StonesGate604/Tabletop-OS/pc-runtime/models/README.md

# MediaPipe 手部模型

模型二进制不提交到仓库。执行：

```powershell
python pc-runtime/tools/download_hand_model.py
```

固定资源：`hand_landmarker/float16/1`，7819105 字节。
SHA256：`fbc2a30080c3c557093b5ddfc334698132eb341044ccee322ccf8bcf3607cde1`。
下载脚本会验证哈希；程序不会在启动时自动联网下载。

来源与模型说明：[MediaPipe 官方 Hand Landmarker](https://developers.google.com/edge/mediapipe/solutions/vision/hand_landmarker)。
