StonesGate604/Tabletop-OS/docs/Tabletop_OS_Project_Context.md

# Tabletop OS 项目上下文与当前架构基线

> **2026-10-26 状态更新：** PC Runtime、双捏合与舵机升降序列、仿真、离线视觉和 PC→Pi TOSF 最终帧通道现已实现并通过软件测试。本机升降端点已实测为 81° 最高吸附、118° 最低释放，测试链路使用 45 mm/s；行程复测为 X=298 mm（`344−46`）、Y=466 mm（`514−48`），旧机械相机标定已失效。稳定时间、安全间距和真实硬件闭环仍待验。当前实现以 [技术说明书](TABLETOP_OS_TECHNICAL_GUIDE_ZH.md) 和 [实机联调记录](HARDWARE_COMMISSIONING_ZH.md) 为准；下文的 2026-10-12 状态与后续建议保留为历史背景，不应当作最新功能清单。

> 用途：给当前及后续 Codex 任务提供统一上下文。开始新任务时，先让 Codex 阅读本文件和相关模块的 README，再决定是否修改代码。
>
> 更新原则：本文件区分“当前事实”“近期目标”和“未来设计”。讨论过的能力不等于已经实现。
>
> **架构更新（2026-10-12）：** 本文中由 Pi 直接绘制光标和拖影的描述，记录的是已经实现并保留的 v0.1 诊断基线。正式产品边界已经调整为“PC 合成最终画面，Pi 只接收像素并输出 HUB75”。当前边界以仓库根目录 `README.md` 和 `protocol/README.md` 为准。

## 1. 项目一句话

Tabletop OS 是一个结合摄像机感知、HUB75 灯光反馈、CoreXY 电磁驱动和游戏逻辑的实体数字桌游系统。最终目标是让玩家、确定性的游戏规则和 LLM 都能提出高层意图，并由桌面通过光与棋子运动作出可见、可验证的物理回应。

LLM 永远不直接控制电机。任何由 LLM 或游戏逻辑提出的动作，都必须先经过规则与安全层验证，再转成有限、明确的运动命令。

## 2. 当前仓库事实（2026-10-12）

仓库中已经存在：

- `experiments/arduino/CoreXY_Controller/`：Arduino UNO R3 + CNC Shield V3 + A4988 的 CoreXY 调试固件与说明。
- `experiments/arduino/Limit_Servo_Test/`：两个限位开关与舵机的独立测试程序。
- `experiments/arduino/Integrated_Hardware_Test/`：两个步进电机、两个限位开关和舵机的联合测试程序；实物测试已通过。
- `firmware/arduino/TabletopOS_Lower_Controller/`：正式下位机固件及协议说明。重新测得 X=298 mm（`344−46`）、Y=466 mm（`514−48`），减数为 moving carriage 尺寸；两个限位均位于最小端起点。当前正式固件使用 `X_AXIS_SIGN=1`、`Y_AXIS_SIGN=1`，两个回零方向均为 `-1`，使 X/Y 分别向左、向下寻找起点限位。两个 A4988 驱动插槽下的三个细分跳帽均已安装，固件按 1/16 细分、GT2 皮带和 16 齿同步轮配置为 `100 steps/mm`。
- `experiments/raspberry-pi/gpio_high_test.py`：已有 GPIO/HUB75 方向的测试代码。
- `docs/Tabletop_OS_Development_Roadmap.md` 与 `docs/Tabletop_OS_中文路径规划图.md`：较长期的产品与研究路线。

旧版 `CoreXY_Controller` 调试固件的真实能力：

- 支持 `ENABLE`、`ZERO`、`MOVE x y speed`、`JOG dx dy speed`、`POS`、`DISABLE` 和即时停止字符 `!`。
- `MOVE` 是阻塞式、一次完成一个目标的任务语义；运动中除 `!` 外的输入会被丢弃。
- 位置来自步进脉冲计数，是开环机构位置估计，不是棋子位置真值。
- `ZERO` 是手动设零，不是自动回零。
- 尚未实现连续更新目标的 `SET_TARGET`、命令编号、周期遥测、WebSocket 桥接或完整 HUB75 联动。
- 该旧版仍可用于手动点动排障，但不再作为正式通信固件。

当前 `TabletopOS_Lower_Controller` 正式固件的真实能力：

- 非阻塞执行自动 `HOME`、带编号的 `MOVE_TO` 和最新值语义的 `SET_TARGET`；运动过程中仍持续解析串口。
- 返回 `ACK`、`STARTED`、`COMPLETED`、`ERROR` 和可选周期 `STATE` 快照，并拒绝旧任务编号或倒序目标序号；周期遥测上电默认关闭，可用 `TELEMETRY ON/OFF` 控制。
- 具有受控 `STOP`、即时 `!`、软限位、意外硬限位故障、跟随目标超时、舵机超时和错误恢复状态。
- 已使用本机 Arduino AVR 工具链为 Arduino Uno 编译通过。当前代码参数为：任务移动软件上限 50 mm/s、连续跟随 20 mm/s、加速度 60 mm/s²、最大 8000 步进事件/秒、回零速度 8/2 mm/s。50 mm/s 尚未完成实物验证；自动回零、全行程软限位、分级速度和连续跟随仍需按当前 1/16 细分配置重新测试。

## 3. 现在真正要完成的目标

不要直接实现完整 Tabletop OS。当前集成目标是建立一条最小、可观察的“手势选取并移动单个磁性棋子”闭环：

```text
摄像机跟踪手在桌面上的位置
   ↓ PC 在最终画布中绘制实时圆环光标
PC 发送完整像素帧，Pi 输出到 HUB75
   ↓ 光标只是视觉反馈，不驱动机构
手位于棋子上方并做抓取手势
   ↓ 选中当前棋子
手移动到目标位置
   ↓ 圆环继续跟随并更新目标预览，不驱动机构
释放或明确的确认手势
   ↓ 生成一次 MOVE_TO 任务
PC → Raspberry Pi → Arduino / CoreXY
   ↓
机构移动磁性棋子
   ↓ Arduino STATE 位置估计
Raspberry Pi 回传实际坐标 → PC 生成蓝色轨迹 → Pi 显示最终帧
   ↓
轨迹在保留一段时间后逐渐熄灭
```

推荐按下面顺序推进：

1. 按当前 1/16 细分配置，让 Arduino 单独可靠完成回零和小范围 `MOVE_TO`。
2. Pi 通过串口发送单次目标，并正确处理 `ACK`、`STARTED`、`COMPLETED`、`ERROR` 和 `STATE`。
3. 先用已经实现的 Pi 本地蓝色轨迹验证 Arduino 遥测、坐标方向和 HUB75 映射；这一步属于 v0.1 诊断模式。
4. 实现 PC 最终画面合成与 Pi 像素帧接收，用鼠标模拟手部位置；PC 绘制圆环、目标预览和基于实际机构坐标的蓝色轨迹，Pi 只显示最终帧。
5. 用摄像机手部识别替换鼠标：手部位置持续更新 PC 画布，抓取手势只锁定棋子，手移动同时更新光标和目标预览，释放或确认手势才提交一次 `MOVE_TO`。
6. 完成单磁性棋子的完整演示后，再加入 AprilTag 棋子身份、网格坐标、游戏规则、专用游戏编写工具和 LLM。

当前最有价值的阶段性演示是：

> 用户的手进入有效桌面区域后，PC 在最终画布中生成实时圆环光标并发送给 Pi 显示。用户在棋子上方做抓取手势将其选中，把手移到另一处并做释放或确认手势；系统随后移动该磁性棋子。PC 根据 Pi 回传的机构实际坐标生成不含红色的蓝色轨迹拖影，Pi 显示最终画面，轨迹在设定时间后消失。

第一版只处理一个已知磁性棋子，不要求先完成多棋子身份识别。选中与目标手势在提交前都属于 PC 端交互状态，不应直接流式控制电机。

## 4. 三层职责

### PC：Tabletop OS 专用编写程序、感知与高层决策

第一版负责：

- 运行专门为 Tabletop OS 设计的游戏编写与运行程序，不以兼容 Unity、Godot、p5.js 等通用游戏引擎为目标；
- 读取鼠标或摄像机输入；
- 识别手的位置以及抓取、移动、释放/确认手势；
- 维护 `IDLE → SELECTED → AIMING → COMMITTED → MOVING` 的本次交互状态；
- 将相机坐标转换为统一的桌面物理坐标；
- 在手部跟踪有效时，在 PC 画布中生成实时圆环、目标预览和相关动画；
- 根据 Pi 回传的 Arduino 实际坐标生成运动轨迹；
- 合成最终 64×96 画面并通过画面通道发送给 Pi；
- 只在动作提交后向 Pi 发送一次经过边界检查的移动任务；
- 可选地显示调试信息。

以后才负责：

- AprilTag 棋子识别；
- 棋盘格映射；
- 游戏规则、逻辑状态和玩家动作判断；
- LLM 意图解析及规则验证；
- 棋子状态估计与系统运动验证。

### Raspberry Pi：协调、桥接与灯光

正式运行负责：

- 接收 PC 已确认的单次移动目标；
- 接收 PC 合成的最终像素帧，丢弃不完整或过期帧，并在 VSync 时输出到 HUB75；
- 只处理面板排列、方向、亮度、超时清屏和故障红色通道屏蔽，不理解光标、棋子或游戏特效；
- 为目标分配或校验命令编号，并把一次 `MOVE_TO` 任务发给 Arduino；
- 接收 Arduino 的状态或位置回报；
- 把 Arduino 的状态与实际位置回传给 PC，作为 PC 生成真实运动轨迹的输入；
- 维护 PC 连接和串口连接的健康状态；
- 在连接断开、命令失败或状态异常时停止新任务并回报错误。

Pi 是当前系统协调器，但不应替 Arduino 生成精确步进脉冲，也不应让 Arduino 保存一长串游戏动作队列。

已经实现的 Pi Bridge v0.1 仍会接收手部位置并在本地绘制圆环，同时根据 Arduino `STATE` 绘制蓝色拖影。这一功能保留为坐标、面板与机构链路的诊断基线。正式运行时这些图层全部在 PC 合成，Pi 只接收最终像素。

### Arduino：低层运动与硬件安全

负责：

- CoreXY 步进时序、方向、速度与加减速；
- 位置计数和软行程检查；
- 限位、回零、停止和故障状态；
- 执行当前运动任务，或在连续模式下追踪最新目标；
- 回报自身的机构位置、当前目标、模式与错误。

Arduino 知道的是执行器/磁铁的位置估计，不应声称自己直接知道棋子实际在哪里。

## 5. 两种运动语义

正式协议必须区分任务式运动和连续目标更新。它们不冲突，服务于不同场景。

### 5.1 `MOVE_TO`：任务语义

示意：

```text
MOVE_TO 142 300.0 400.0 20.0
```

含义：执行编号为 `142` 的完整运动任务，到达后报告完成。适用于：

- 把棋子从一个格子移动到另一个格子；
- 回合制游戏动作；
- 校准或明确的点到点操作。

Pi 一次只下发一个任务，等待该任务完成或失败，再决定下一步。Arduino 不维护长游戏任务队列。

当前“抓取选中—移动手—释放确认”的演示使用 `MOVE_TO`。手在空中移动时只改变 PC 端的目标预览；只有释放或明确确认后才创建一个新的 `command_id` 并提交任务。

### 5.2 `SET_TARGET`：最新值语义

示意：

```text
SET_TARGET 501 300.0 400.0
SET_TARGET 502 315.0 407.0
SET_TARGET 503 330.0 420.0
```

含义：进入连续跟随模式，并用序号更大的新目标覆盖旧目标。适用于：

- 手部追踪；
- 鼠标、摇杆或远程操控；
- 调试与遥操作。

`SET_TARGET` 不用于当前的棋子放置手势演示，否则机构会在用户尚未确认目标时持续追随手部位置。该命令保留给以后明确选择的连续遥操作模式。

这三条不是三个等待完成的任务。Arduino 始终追踪最新有效目标；如果 `502` 之后才收到 `501`，应忽略 `501`。

### 5.3 当前实现与目标协议的关系

旧版 `CoreXY_Controller` 的 `MOVE x y speed` 是 `MOVE_TO` 的早期原型，没有 `command_id`，并且运动期间阻塞；它不再作为正式通信固件。当前 `TabletopOS_Lower_Controller` 已实现非阻塞、带编号的 `MOVE_TO` 和最新值语义的 `SET_TARGET`。

## 6. 最小通信协议建议

当前 PC 与 Pi 使用 TCP 7420 的 NDJSON 控制通道和 UDP 7421 的 v0.1 诊断光标通道；下一版将在此基础上增加或替换为最终像素帧通道。Pi 与 Arduino 使用 115200 波特单行文本串口协议。

### 6.1 Pi → Arduino

近期需要的命令：

```text
ENABLE
HOME
MOVE_TO <command_id> <x_mm> <y_mm> <speed_mm_s>
SET_TARGET <target_seq> <x_mm> <y_mm>
STOP
STATUS
DISABLE
```

说明：

- `HOME` 已在当前正式固件中实现，包含快寻、退回和慢速二次触发；旧版实验固件中的手动 `ZERO` 不能代替回零。
- `STOP` 表示软件受控停止；真实硬件急停仍应能切断危险输出。
- 电磁铁控制以后再加入 `MAGNET_ON` / `MAGNET_OFF`，并必须带超时与热安全策略。

### 6.2 Arduino → Pi

建议的事件：

```text
ACK <command_id>
STARTED <command_id>
COMPLETED <command_id>
ERROR <code> <related_id>
```

建议的周期状态快照：

```text
STATE <telemetry_seq> <mode> <active_id> <actual_x_mm> <actual_y_mm> <target_x_mm> <target_y_mm>
```

V0 不必一次实现全部字段。最低限度可以先有：

```text
POS <telemetry_seq> <x_mm> <y_mm>
```

### 6.3 PC ↔ Pi

PC 与 Pi 在调试阶段可以使用同样的概念，但消息可以是 JSON，方便扩展。例如：

```json
{
  "type": "pointer_state",
  "seq": 2401,
  "visible": true,
  "x_mm": 126.0,
  "y_mm": 284.0,
  "gesture": "open",
  "confidence": 0.94,
  "captured_at_ms": 1750000000000
}
```

`pointer_state` 使用“最新值覆盖”语义，不需要 ACK，只能更新 HUB75 光标。Pi 丢弃倒序帧，并在约 200 ms 没有收到新位置时隐藏或快速淡出光标，避免将旧位置冻结在桌面上。该消息不能被转发为 Arduino 命令。

只有释放或明确确认手势才产生可靠的移动任务，例如：

```json
{
  "type": "move_to",
  "command_id": 503,
  "x_mm": 330.0,
  "y_mm": 420.0,
  "speed_mm_s": 20.0,
  "sent_at_ms": 1750000000000
}
```

Pi 回给 PC 的状态示例：

```json
{
  "type": "motion_state",
  "seq": 3812,
  "mode": "TRACKING",
  "active_id": 503,
  "actual_x_mm": 324.0,
  "actual_y_mm": 410.0,
  "target_x_mm": 330.0,
  "target_y_mm": 420.0,
  "telemetry_age_ms": 6
}
```

这些是目标格式，不代表仓库已经实现。

## 7. 同步原则

PC、Pi 和 Arduino 不需要共享同一个循环，也不需要逐帧锁步。

可能的独立速率是：

- Arduino 控制循环：数百 Hz 或由定时器/步进规划器决定；
- Arduino 遥测：约 20–100 Hz，按串口负载实测；
- PC 渲染：约 60 Hz；
- CV：约 30 Hz；
- PC → Pi 光标位置：跟随 CV，约 30 Hz，只保留最新值；
- 当前演示的 `MOVE_TO`：只在释放/确认时提交一次；以后启用的连续 `SET_TARGET` 才使用限频和最新值语义。

同步依靠以下机制：

- 离散任务使用 `command_id`，明确 ACK、开始、完成或失败属于哪个任务；
- 连续目标使用单调递增的 `target_seq`，旧目标不覆盖新目标；
- 遥测使用 `telemetry_seq`，接收方忽略倒序或重复包；
- 周期发送完整状态快照，使漏掉单个事件后仍能恢复；
- PC/Pi 保存接收时间并计算 `telemetry_age_ms`；
- 连接超时或目标太旧时进入安全停止，而不是无限追踪最后一个旧目标。

数据所有权必须清楚：

- PC 拥有高层意图、逻辑游戏状态和视觉观察；
- Pi 拥有连接状态、最近目标、最新手部光标镜像和 Arduino 状态镜像；
- Arduino 拥有实时执行器状态和硬件故障状态。

## 8. Arduino 目标状态机

目标状态可以保持很小：

```text
UNREFERENCED
    └── HOME / ZERO 成功 → IDLE

IDLE
    ├── MOVE_TO → TASK_MOVE
    ├── SET_TARGET → TRACKING
    └── DISABLE → UNREFERENCED

TASK_MOVE
    ├── 到达 → COMPLETED → IDLE
    ├── STOP → IDLE 或 UNREFERENCED（取决于是否可能失步）
    └── 限位/故障 → ERROR

TRACKING
    ├── 新 SET_TARGET → 留在 TRACKING，覆盖目标
    ├── STOP / 超时 → IDLE
    └── 限位/故障 → ERROR

ERROR
    └── 明确复位并重新建立坐标参考 → IDLE
```

是否在受控停止后保留坐标参考，要依据实际步进与机械行为决定。现有 `!` 会释放电机并使原点失效，这是当前安全假设，不应在没有实测依据时放宽。

## 9. “两个声音”：机构估计与视觉观察

加入 AprilTag 后，同一个棋子的移动会同时产生两类信息：

- Arduino：磁铁/执行器根据脉冲计数估计到哪里；
- Camera + CV：棋子的 AprilTag 被实际观察在哪里。

这不是重复数据，也不应强行合并为一个变量：

```text
commanded_position   系统要求去哪里
actuator_position    机构估计磁铁在哪里
vision_observation   摄像机看到棋子在哪里
estimated_position   系统综合判断棋子在哪里
logical_position     游戏规则已经确认的棋盘位置
```

运动过程中，机构估计适合提供低延迟轨迹；视觉适合检查棋子是否跟上磁铁。运动结束后，棋子的最终物理位置应由视觉确认，而不是仅凭电机“已经到达”。

未来系统移动棋子时，要设置类似以下上下文：

```text
motion_owner = SYSTEM
active_command_id = 142
```

此时 CV 仍更新观察值，但不能把系统造成的位移再解释成一次玩家动作。Arduino 报告完成后，还需等待视觉确认目标棋子稳定在期望位置，才能提交游戏状态。

玩家手动移动棋子时，如果没有活动的系统运动，CV 才能在位置稳定一段时间后产生候选 `PLAYER_MOVE`。

以上属于 AprilTag 阶段的设计约束，当前手部跟随演示不需要实现 `WorldModel`、`StateEstimator` 或 `motion_owner` 类。

## 10. 坐标约定

模块之间统一传递桌面物理坐标，单位使用毫米：

```text
camera pixels
    ↓ 标定/透视变换
board coordinates (x_mm, y_mm)
    ↓ CoreXY 运动学
motor A/B steps
```

约定必须在实现前写清：

- 原点在桌面的哪个角或哪个机械参考点；
- X、Y 正方向；
- 可运动边界；
- 摄像机画面是否镜像或旋转；
- HUB75 像素方向；
- 毫米到 LED 像素、毫米到步数的变换。

PC 不发送电机 A/B 步数，Pi 不猜相机像素。所有跨设备目标先转换为板面毫米坐标。

## 11. HUB75 行为

正式画布由 PC 合成。推荐的图层顺序是：棋盘/游戏底图 → 基于 Arduino 实际位置的运动轨迹 → 选中与目标提示 → 实时跟手圆环。PC 将这些图层压平为最终 64×96 像素帧后发送给 Pi。

Pi 的显示循环必须独立于网络和串口消息到达，只负责保存最新完整帧并在 VSync 时切换：

```text
latest_complete_frame
last_frame_received_at
display_health
```

Pi 还负责面板物理映射、亮度、颜色输出限制和帧超时清屏。因为当前面板的红色通道存在局部故障，硬件输出层暂时继续强制 `R=0`。灯板刷新不能反过来阻塞运动通信。

Pi Bridge v0.1 中的 `latest_hand_cursor`、`trail_history` 和本地图层合成只作为诊断模式保留，用于在 PC Runtime 完成前验证硬件链路；它们不属于最终游戏渲染接口。

## 12. 安全底线

- 首次测试只做低速、小距离、空载或解除危险连杆的动作。
- 软限位依赖坐标参考与不失步，不能替代硬件限位和物理急停。
- 电机、电磁铁和舵机的电源、限流、共地与散热必须依据具体器件确认。
- 电磁铁必须有默认关闭、最长通电时间与异常断连关闭策略。
- 网络断开、串口断开、目标数据过期、限位触发和解析错误都必须导向定义明确的安全状态。
- 任何 LLM 输出只能成为待验证的高层建议，不能直接进入串口或 GPIO。

## 13. 分阶段验收标准

### M0：CoreXY 单机验证（当前最近目标）

- 上电后发送 `CONFIG`，确认实物跳帽与 `MICROSTEPS=16`、`STEPS_PER_MM=100` 一致；
- `HOME` 的 X/Y 寻限位方向、退回和二次慢速触发均符合预期；
- 使用正式固件的 `MOVE_TO` 低速完成中心附近的小范围正方形；
- `!`、`STOP`、软边界和硬限位故障行为经过实物验证；
- 记录实测距离误差、可靠速度、加速度和可能发生失步的边界。

### M1：Pi → Arduino 单任务链路

- Pi 能发送一个点到点目标；
- Arduino 明确返回接受、完成或错误；
- 不重复执行旧命令；
- 断连和停止行为可预测。

### M2：Arduino → Pi → HUB75 诊断轨迹

- Pi 持续获得机构位置；
- HUB75 独立刷新，不因串口间歇而冻结；
- 显示位置方向与实体运动方向一致。
- 轨迹只使用蓝色通道，所有轨迹像素保持 `R=0`；
- 每个轨迹点带时间戳，并在可配置寿命内逐渐变暗直至清除；
- 轨迹来源是 Arduino 回报的位置估计，而不是 PC 预期路径。
- 这一里程碑验证的是 v0.1 诊断渲染，不固定最终职责边界。

### M3：鼠标模拟选取与放置

- 鼠标进入有效桌面区域后，HUB75 始终在对应位置显示圆环光标；
- 圆环、目标预览和轨迹由 PC 合成到最终帧，Pi 不解析这些视觉语义；
- 第一次点击模拟在棋子上方抓取并选中；
- 鼠标移动持续更新 HUB75 光标和目标预览，不驱动机构；
- 第二次点击或确认操作生成一个带编号的 `MOVE_TO`；
- PC 能看到任务的接受、开始、完成或错误状态；
- 任务执行时，HUB75 显示随实际机构位置生成的蓝色拖影。

### M4：手势选取与移动完整闭环

- 用摄像机手部坐标和抓取/释放手势替换鼠标，不改变 Pi/Arduino 边界；
- 跟踪有效时，HUB75 圆环始终位于手下方；抓取只改变圆环样式和交互状态；
- 只有手位于当前磁性棋子上方并满足抓取判定时才能进入 `SELECTED`；
- 手移动期间持续更新圆环光标和经过标定的目标预览，但不驱动机构；
- 释放或确认手势提交一次 `MOVE_TO`，随后进入 `MOVING` 并暂时拒绝新的手势任务；
- 手丢失、手势取消、目标越界或连接异常不会触发运动；
- 同屏或日志显示 selection、target、actual、命令编号、延迟与状态；
- 完成后蓝色轨迹按设定寿命消失，系统回到可选择状态。

### M5：AprilTag 棋子验证

- 分开显示 actuator position 与 piece observation；
- 计算并记录二者误差；
- 能识别棋子未跟上、标记丢失或终点不符；
- 此时再引入系统动作与玩家动作的归属判断。

### M6：Tabletop OS 专用游戏编写程序与游戏逻辑

- 毫米坐标稳定映射到格子；
- 使用自研的 Tabletop OS 游戏编写与运行环境描述棋盘、棋子、规则、视觉效果和物理动作；
- 不把兼容通用游戏引擎作为当前目标；
- 合法动作才会被转换为物理任务；
- 物理移动经视觉确认后才提交逻辑状态；
- 最后再接入 LLM 的结构化意图。

## 14. 当前明确不做的事

在 M0–M4 阶段，不要提前实现：

- 完整 `WorldModel`、`StateEstimator`、`PieceManager`、`EventBus`；
- Kalman Filter 或复杂传感器融合；
- Arduino 端的长任务队列；
- 多棋子自动调度与避障；
- 完整游戏规则系统；
- 面向 Unity、Godot、p5.js 等通用引擎的 SDK 或插件系统；
- LLM 直接生成或执行硬件动作；
- 为未来扩展而引入复杂消息中间件。

只有在当前里程碑的真实测试暴露出需要时，再添加相应抽象。

## 15. 给后续 Codex 任务的入口指令

可以在新任务开头使用：

> 请先阅读 `Tabletop_OS_Project_Context.md`，并把它视为当前设计基线；同时检查目标模块的 README 和实际代码，不要把文档中的未来协议当成已实现功能。只推进我指定的当前里程碑，保留现有实物安全约束，并在修改后说明哪些内容已验证、哪些仍需上机验证。

如果新实验推翻了本文件中的假设，应先记录实测证据，再更新本文件，而不是让代码和架构说明长期分叉。
