StonesGate604/Tabletop-OS/hardware/reference/DELIXI_CDKU-S200_official_dimension_drawing.png

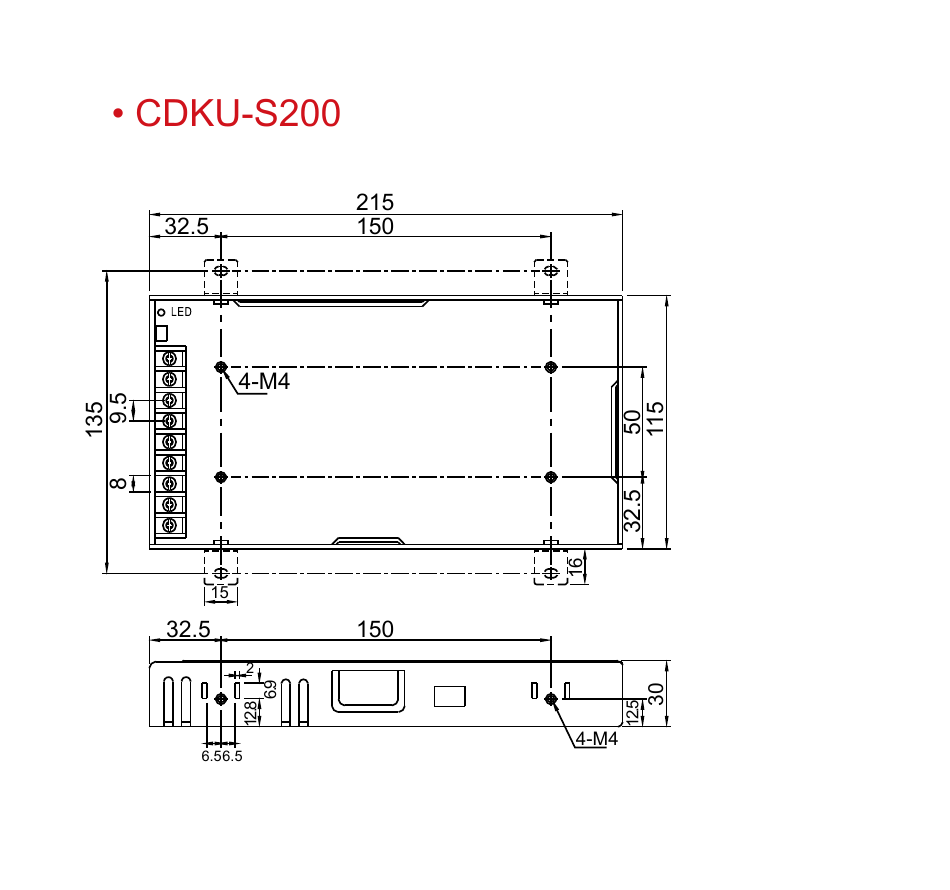
hardware/reference/DELIXI_CDKU-S200_official_dimension_drawing.png
