StonesGate604/Tabletop-OS/docs/VALIDATION_2026-10-24.md

# 2026-10-24 摄像头、手势、标签与磁吸滑台联调

## 本次结果

用户现场确认：摄像头 → 手势/AprilTag → 两块灯板反馈 → 磁吸滑台运动的链路已跑通。本记录是联调检查点，不代表完整升降吸附流程或全桌位置精度已经验收。

- 使用 Insta360 虚拟摄像头，输入 1280×720；增加白板裁切与启动黑帧等待。
- 灯板使用两块 64×32 面板组成 64×64；灯板覆盖区域单独四点映射，不把机械行程直接缩放成屏幕坐标。
- 手势光圈、AprilTag 绿色方框共用灯板映射；支持独立 X 镜像和整体 180° 显示旋转。
- 标签被遮挡时保留最后位置及亮度，直到再次观测更新；摄像头窗口标注 HOLD。位置缓存仅在当前进程内保留。
- 双捏合可选择标签、预览目标，并在显式开启持续吸合模式后提交单次运动。
- 磁吸滑台完成了实机回零、低速定位与联动测试；当前测试速度为 15 mm/s。

## 当前运行方式

先准备本机 `config/local-runtime.json`、相机模型、`local-display-map.json`（灯板映射）与 `local-calibration.json`（机械毫米映射）。运动模式要求已回零；不要同时运行其他占用 Pi 控制连接的工具。

仓库根目录运行：

```powershell
./pc-runtime/.venv/Scripts/python.exe pc-runtime/tools/hand_pointer.py --config pc-runtime/config/local-runtime.json --reuse-map --constant-engage --allow-pickup-offset --speed 15
```

这条命令复现本次现场测试设置：磁铁由机构保持吸合，不发送升降舵机或自动接近命令；临时跳过棋子与执行器位置对齐检查。位置一致性检查默认开启，省略 `--allow-pickup-offset` 即恢复。默认速度仍为 2 mm/s，现场使用的 15 mm/s 由参数显式指定。

单次距离不再额外限制，但机械工作区边界仍生效。第二次捏合确认时必须重新看到选中标签；仅有缓存方框不能启动运动。电机完成后还需新的独立标签观测确认棋子到位。持续捏合、恢复连接或标签重现都不会自动重发旧动作。

按 C 取消/清除结果；Space 请求停止；Esc 退出。Pi 的安全停止可能发送 SERVO_OFF，此测试模式不保证舵机一直通电保持角度。

## 尚待完成

- 舵机抬起/吸合角度未标定，正式 release → seek → engage → drag → release 流程尚未实机验收。
- 本次发现相机毫米位置与机构报告位置存在偏差；需要重新核对机械标定、磁铁中心及标签中心偏置，再恢复对齐检查。
- 灯板方向由用户现场确认可用；全桌映射误差、滑脱与遮挡下的运动验证仍需系统验收。

## 自动验证

本次提交前 Python 单元测试共 81 项通过，涵盖原有 Runtime/协议、相机裁切、标签缓存、双捏合、灯板到机械坐标转换、持续吸合动作与停止/超时行为。测试使用离线图像、模拟设备及本机回环，不驱动实物。

本机配置、校准结果、模型、日志及测试图片按既有忽略规则保留在电脑，不纳入 Git 提交。
