StonesGate604/Tabletop-OS/pi-bridge/include/tabletop_os/hub75_renderer.hpp

#pragma once

#include <atomic>
#include <memory>
#include <thread>

#include "tabletop_os/config.hpp"
#include "tabletop_os/shared_state.hpp"

namespace tabletop_os {

class Hub75Renderer {
 public:
  Hub75Renderer(const AppConfig& config, SharedState& state);
  ~Hub75Renderer();

  bool Initialize();
  void Start();
  void Stop();
  int Width() const;
  int Height() const;

 private:
  class Impl;
  std::unique_ptr<Impl> impl_;
};

}  // namespace tabletop_os
