StonesGate604/Tabletop-OS/(commit log)

2026-10-23 fix: stabilize hardware control and add dual-panel diagnostics
    [TabletopOS_Lower_Controller.ino, config.cpp, config.hpp, hub75_renderer.cpp, lower_controller_test.cpp]
2026-10-24 feat: integrate camera gestures, AprilTags and magnet stage testing
2026-10-27 feat: add calibrated pick-place hardware flow
2026-10-27 fix: support three-panel LED canvas
    [config.cpp, config.hpp, frame_protocol.cpp, frame_protocol.hpp]
2026-10-27 docs: describe three-panel display calibration
2026-10-27 feat: improve LED panel diagnostics
2026-11-04 feat: checkpoint Patrol V1 board integration
    Save configurable logical piece bindings, virtual guard, hand cursor and occlusion previews, RGB bridge output, and existing motion fixes. Archive the working Tag 0 board configuration with restore instructions. Validate with 219 passing PC tests.
